encukou/ledtris/(commit log)

2014-12-18 Playing around with micropython inline assembly
2014-12-18 Mostly working! (sans bugs)
    Demoed at Pražské Pyvo
    [main.py]
2016-10-24 Add holder for 8 LED strips
    [comb.scad]
2016-10-24 Adjustments after first printing
    [comb.scad]
2016-10-24 Changes after 2nd print
    [comb.scad]
2016-10-24 Adjust tolerance
    [comb.scad]
2016-10-24 Add a game controller model
    [controller.scad]
2016-10-24 controller: Move screw holes back
    [controller.scad]
2016-10-24 controller: Add tolerance to battery door hole, put more guide triangles around it
    [controller.scad]
2016-10-24 controller: Put wire guide nooks on the outside of the door terminal
    [controller.scad]
2016-10-24 controller: Shift the pin holes to fit the board
    [controller.scad]
2016-10-26 Start again with new LED strip driver for Pyboard 1.1
2016-10-26 Reset speedup when a piece is set
    [main.py]
2016-10-26 Rework shapes and handling
    [main.py]
